RTimothyEdwards/caravel_openframe_project/docs/caravel_openframe.png

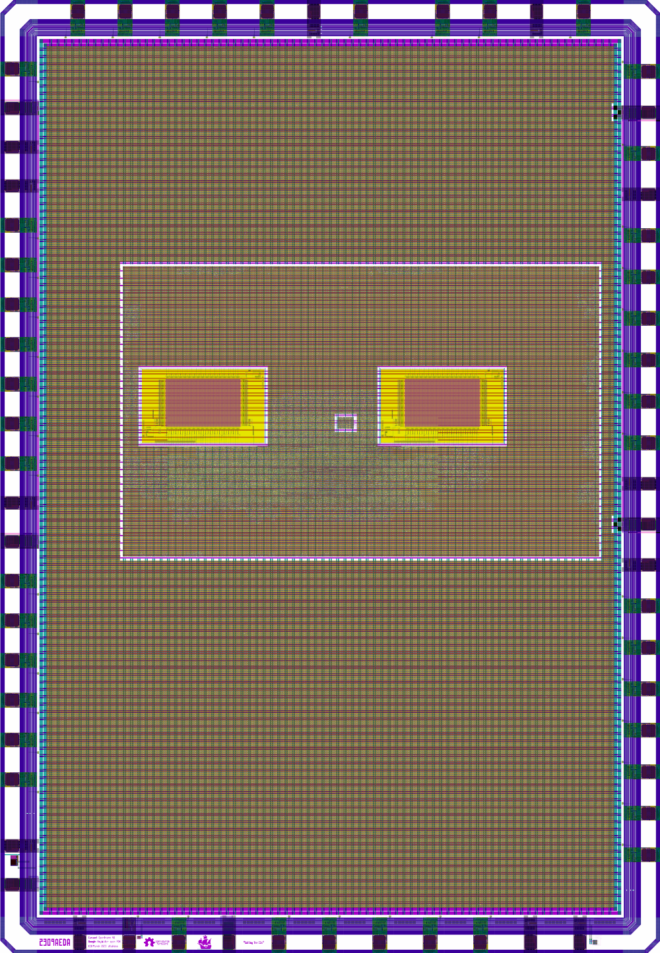
docs/caravel_openframe.png
