RTimothyEdwards/caravel_openframe_project/(threads)

Thread 1 (2023-05-14):

Select out of bounds on signal `gpio_dat_o[*]`

kareefardi, 2023-05-14:
In the following section, in `picorv32.v`:
```
	for (i = 0; i < 32; i = i + 1) begin
	    assign gpio_all_dat_o[i] = |(gpio_dat_o[i][`OPENFRAME_IO_PADS-1:0]);
	end
```

``[`OPENFRAME_IO_PADS-1:0]`` is out of bound for the 32 bus `gpio_data_o[i]`. I believe the intention behind the for loop was to OR all i'th bit of each PADS gpio bus. The current for loop doesn't accomplish that.

RTimothyEdwards, 2023-05-15:
@kareefardi :  iverilog seemed to be okay with it but I can't get the synthesis tools to understand it.  The intent seems perfectly clear but apparently somehow is not valid verilog (except to iverilog).  Do you know a way to restate it properly?

RTimothyEdwards, 2023-05-15:
@kareefardi :  Note that very little of this project has actually been tested through verilog testbenches.  There's only one testbench, but it tests the GPIO vector setting, so it actually validates iverilog's understanding of the "for" loop above, and iverilog handles it correctly.

RTimothyEdwards, 2023-05-15:
@kareefardi :  There is a `caravel_openframe_wrapper.def` file in `caravel_openframe_project/openlane/openframe_project_wrapper/fixed_dont_change/` which ultimately should reside in the `caravel` repository.  It is incomplete;  I copied it from the original user project wrapper and modified it for the correct openframe pins.  However, there are tracks and sites defined in it that correspond to the original user project wrapper and are limited to the smaller area that it has compared to the openframe area.  However, when I ran openlane, it appeared to honor the DIEAREA and used the entire area for placement.  I assume that Openlane/OpenROAD can rewrite a corrected DEF at some point in the flow?

So far, my attempt to run this through Openlane (and ignoring the for() loop error just to see if I could get through the entire flow) gets through placement, at which point it fails to complete placement and I'm not sure how to proceed from there.   Looking at the placement result, it looked fine, and the macros were placed correctly, but the number of logic gates looked way too low (and the sparse placement doesn't sync with the failure to complete placement).

Please bear in mind that the current state of this project is where I was just trying to get it to complete synthesis, place, and route.  I have made no attempt to verify anything or apply timing constraints, other than copying some files from the caravel management SoC that undoubtedly need editing.

kareefardi, 2023-05-16:
`gpio_dat_o` is a 44 x 32 array of arrays. The loop is attempting to access the i'th 32 bit bus while selecting a range of size 44. This results in the yosys warning of out of bounds.

RTimothyEdwards, 2023-05-24:
@kareefardi :  If you can suggest what the double loop would look like to concatenate the bits of an array instead of using the "|" operator which yosys will not apply to an array, then please post the solution here.

M0stafaRady, 2023-05-29:
I can see the same warning in VCS.

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

RTimothyEdwards, 2023-05-29:
Yes, it needs to be rewritten, if someone can suggest a valid way to rewrite it without running the "|" operator on the array.

M0stafaRady, 2023-05-30:
Can you review the suggestion at https://github.com/RTimothyEdwards/caravel_openframe_project/pull/5 ?

Closed 2023-06-01.

Thread 6 (2023-05-31):

How to chain the 2 timers?

M0stafaRady, 2023-05-31:
I tried to add test for chaining the 2 timers but I can't figure out the right configuration for the registers.

M0stafaRady, 2023-06-01:
The high counter start decrement when the low counter reached 0. but the high low counter didn't rollover it stays at 0.
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

here is the sequence I used
```
    // chain
    timer1_chain(1);
    timer0_chain(1);
    // count down
    timer1_upcount(0);
    timer0_upcount(0);
    // one shot
    timer1_oneshot(1);
    timer0_oneshot(1);
    // enable
    timer1_enable(1);
    timer0_enable(1);
    // setting data
    timer1_data(0x1);
    timer0_data(0xF);
```

Closed 2023-06-01.

Thread 7 (2023-06-01):

changing spi master mode gives wrong value

M0stafaRady, 2023-06-01:
When changing the spi master mode from 0 to 1 the written data at sdo is faster 1 cycle the the sck.
Here is a waveform of writing 0x1 when mode is 1(reading at negative edge )
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
This is read as 0x3

The waveform when writing 0x1 when mode is 0 (reading at posedge)
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

RTimothyEdwards, 2023-06-01:
I'm not sure what I'm looking at in the above graphs. . . SCK and SDO both from the SPI master?  In principle, it looks right;  the SDO is aligned with the rising edge of the clock in one mode and the falling edge of the clock in the other mode.  But do you have an SPI slave in the testbench that can also be put in mode 0 or mode 1?  The modes of master and slave have to match, or else yes, there will definitely be race conditions and misinterpretation of data.

M0stafaRady, 2023-06-02:
yes, sck and sdo are from the SPI master.
yes the slave works with different modes.

The mode that align with rising edge is functionally right only the last pose edge reads 1 at this example. However the mode that aligns with negative edge reads 1 at edges number 6 and 7 (counting from 0)
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

Here are some other trials sending byte in this mode to provide more details about the shift between clock driving and data sending.

try sending 0x00 but it sends 0x1
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

try sending 0x7F but it sends 0xFF
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

try sending 0x02 but it sends 0x05
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

try sending 0x03 but it sends 0x07
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

Thread 8 (2023-06-04):

Hold violation on path with start point `gpio_in[38]` (clock)

kareefardi, 2023-06-04:
```
Startpoint: gpio_in[38] (clock source 'clk')
Endpoint: _32086_ (rising edge-triggered flip-flop clocked by clk)
Path Group: clk
Path Type: min
Corner: Typical

Fanout     Cap    Slew   Delay    Time   Description
-----------------------------------------------------------------------------
                          0.00    0.00   clock clk (rise edge)
                          0.00    0.00   clock source latency
                  1.00    0.00    0.00 ^ gpio_in[38] (in)
     1    0.14                           gpio_in[38] (net)
                  1.11    0.05    0.05 ^ clkbuf_0_gpio_in[38]/A (sky130_fd_sc_hd__clkbuf_16)
                  0.13    0.35    0.40 ^ clkbuf_0_gpio_in[38]/X (sky130_fd_sc_hd__clkbuf_16)
     4    0.10                           clknet_0_gpio_in[38] (net)
                  0.13    0.01    0.41 ^ clkbuf_1_0__f_gpio_in[38]/A (sky130_fd_sc_hd__clkbuf_16)
                  0.16    0.23    0.64 ^ clkbuf_1_0__f_gpio_in[38]/X (sky130_fd_sc_hd__clkbuf_16)
     4    0.15                           clknet_1_0__leaf_gpio_in[38] (net)
                  0.16    0.01    0.65 ^ _26519_/B2 (sky130_fd_sc_hd__a22o_2)
                  0.03    0.14    0.79 ^ _26519_/X (sky130_fd_sc_hd__a22o_2)
     1    0.00                           _02974_ (net)
                  0.03    0.00    0.79 ^ _32086_/D (sky130_fd_sc_hd__dfxtp_1)
                                  0.79   data arrival time

                          0.00    0.00   clock clk (rise edge)
                          0.00    0.00   clock source latency
                  1.19    0.00    0.00 ^ gpio_in[38] (in)
     1    0.14                           gpio_in[38] (net)
                  1.30    0.06    0.06 ^ clkbuf_0_gpio_in[38]/A (sky130_fd_sc_hd__clkbuf_16)
                  0.14    0.41    0.47 ^ clkbuf_0_gpio_in[38]/X (sky130_fd_sc_hd__clkbuf_16)
     4    0.10                           clknet_0_gpio_in[38] (net)
                  0.14    0.01    0.48 ^ clkbuf_1_0__f_gpio_in[38]/A (sky130_fd_sc_hd__clkbuf_16)
                  0.16    0.25    0.73 ^ clkbuf_1_0__f_gpio_in[38]/X (sky130_fd_sc_hd__clkbuf_16)
     4    0.15                           clknet_1_0__leaf_gpio_in[38] (net)
                  0.18    0.04    0.77 ^ _15485_/A0 (sky130_fd_sc_hd__mux2_1)
                  0.05    0.17    0.94 ^ _15485_/X (sky130_fd_sc_hd__mux2_1)
     1    0.00                           _05023_ (net)
                  0.05    0.00    0.94 ^ _15486_/B (sky130_fd_sc_hd__and2b_2)
                  0.36    0.39    1.32 ^ _15486_/X (sky130_fd_sc_hd__and2b_2)
     2    0.07                           _05024_ (net)
                  0.36    0.02    1.34 ^ clkbuf_0__05024_/A (sky130_fd_sc_hd__clkbuf_16)
                  0.10    0.27    1.61 ^ clkbuf_0__05024_/X (sky130_fd_sc_hd__clkbuf_16)
     4    0.07                           clknet_0__05024_ (net)
                  0.10    0.01    1.62 ^ clkbuf_1_0__f__05024_/A (sky130_fd_sc_hd__clkbuf_16)
                  0.19    0.26    1.88 ^ clkbuf_1_0__f__05024_/X (sky130_fd_sc_hd__clkbuf_16)
    18    0.18                           clknet_1_0__leaf__05024_ (net)
                  0.19    0.01    1.89 ^ _15487_/B1 (sky130_fd_sc_hd__a21oi_2)
                  0.30    0.30    2.19 v _15487_/Y (sky130_fd_sc_hd__a21oi_2)
     2    0.14                           _00144_ (net)
                  0.30    0.02    2.21 v clkbuf_0__00144_/A (sky130_fd_sc_hd__clkbuf_16)
                  0.09    0.33    2.54 v clkbuf_0__00144_/X (sky130_fd_sc_hd__clkbuf_16)
     4    0.11                           clknet_0__00144_ (net)
                  0.09    0.00    2.54 v clkbuf_1_0_0__00144_/A (sky130_fd_sc_hd__clkbuf_8)
                  0.11    0.23    2.77 v clkbuf_1_0_0__00144_/X (sky130_fd_sc_hd__clkbuf_8)
     4    0.10                           clknet_1_0_0__00144_ (net)
                  0.11    0.00    2.78 v clkbuf_2_0_0__00144_/A (sky130_fd_sc_hd__clkbuf_8)
                  0.14    0.25    3.03 v clkbuf_2_0_0__00144_/X (sky130_fd_sc_hd__clkbuf_8)
     4    0.13                           clknet_2_0_0__00144_ (net)
                  0.16    0.04    3.07 v clkbuf_3_0_0__00144_/A (sky130_fd_sc_hd__clkbuf_8)
                  0.11    0.26    3.33 v clkbuf_3_0_0__00144_/X (sky130_fd_sc_hd__clkbuf_8)
     8    0.09                           clknet_3_0_0__00144_ (net)
                  0.11    0.01    3.34 v clkbuf_5_0_0__00144_/A (sky130_fd_sc_hd__clkbuf_8)
                  0.05    0.20    3.53 v clkbuf_5_0_0__00144_/X (sky130_fd_sc_hd__clkbuf_8)
     4    0.03                           clknet_5_0_0__00144_ (net)
                  0.05    0.00    3.54 v clkbuf_6_0__f__00144_/A (sky130_fd_sc_hd__clkbuf_16)
                  0.12    0.24    3.78 v clkbuf_6_0__f__00144_/X (sky130_fd_sc_hd__clkbuf_16)
    26    0.18                           clknet_6_0__leaf__00144_ (net)
                  0.12    0.01    3.78 v clkbuf_leaf_795__00144_/A (sky130_fd_sc_hd__clkbuf_16)
                  0.05    0.20    3.99 v clkbuf_leaf_795__00144_/X (sky130_fd_sc_hd__clkbuf_16)
     6    0.04                           clknet_leaf_795__00144_ (net)
                  0.05    0.00    3.99 v _1636_1645/A (sky130_fd_sc_hd__inv_2)
                  0.02    0.04    4.03 ^ _1636_1645/Y (sky130_fd_sc_hd__inv_2)
     1    0.00                           net5674 (net)
                  0.02    0.00    4.03 ^ _32086_/CLK (sky130_fd_sc_hd__dfxtp_1)
                          0.10    4.13   clock uncertainty
                          0.00    4.13   clock reconvergence pessimism
                         -0.03    4.10   library hold time
                                  4.10   data required time
-----------------------------------------------------------------------------
                                  4.10   data required time
                                 -0.79   data arrival time
-----------------------------------------------------------------------------
                                 -3.30   slack (VIOLATED)
```
The reason for opening this issue is that the start point and the clock triggering this path have the same source `gpio_in[38]` (`clk`) which is a bit odd.

M0stafaRady, 2023-06-04:
I guess the reason for this hold violation is that the gpio_all_dat_o[15] reads the input to the pads and in the case of gpio[38] the input is the clock.

I think remove dependency over `pad_gpio_in ` in gpio_all_dat_o would fix this. by removing it from the `iomem_rdata  `[register ](https://github.com/RTimothyEdwards/caravel_openframe_project/blob/main/verilog/rtl/gpio_wb.v#LL199C1-L200C1 )

We can also skip gpio[38] in the for loops by this we would lose reading any data from gpio[38].

RTimothyEdwards, 2023-06-04:
What used to be the clock on caravel is now a GPIO (in openframe) that is configured for input to use with the clock (for the project).  This situation should be exactly the same as for any existing user project in caravel that uses a GPIO input as a clock.  Please consult with Marwan as to how users are currently being advised on how to set up timing constraints for a clock input that is being passed to a user project from a GPIO on caravel.

shalan, 2023-06-05:
@RTimothyEdwards

We are hardening an example here. Apparently, there are different mode of operations and this requires cases analysis that cannot be done without a clear requirements document for the example.

Moreover, we need a detailed specs (a block diagram is nice to have) for the clocking module with detailed explanation of possible clocking options and exceptions in order to create correct implementation constraints.

Till we have such information, we cannot proceed.

RTimothyEdwards, 2023-06-05:
@shalan :  It's the same clocking structure that is used on caravel.  The only difference is that the clock pin is named `gpio[38]` instead of `clock`, since the pin is general-purpose as far as the openframe wrapper is concerned, but is used as a clock input by the project.  I had started a timing constraints file for the project, but I wasn't sure how to specify the clock in all places to make sure that openlane understands that pin `gpio[38]` is the input clock.

Thread 10 (2023-06-05):

Wrong dimensions for `gpio_analog_pol[33]` in template def

kareefardi, 2023-06-05:
`gpio_analog_pol[33]` is a met3 pin with width < met3 min width.

RTimothyEdwards, 2023-06-05:
The pin used to be attached to metal2 and so it is the width of metal2, but the underlying metal3 layer is sufficiently wide.  It looks like I should have run extraction before generating the DEF so that it would pick up the rest of the net;  by not doing so, it output only the pin label and area.

RTimothyEdwards, 2023-06-05:
But more to the point, all the other pins that had been on metal2 were resized to the full width of metal3, except `gpio_analog_pol[33]` was missed, which is a mistake.

RTimothyEdwards, 2023-06-07:
@kareefardi :  Should be fixed now.

Closed 2023-08-25.

Thread 16 (2023-08-17):

master spi interrupt behaviour

M0stafaRady, 2023-08-17:
The current interrupt in the spi master is triggered once the interrupt is enabled. Since the [condition](https://github.com/RTimothyEdwards/caravel_openframe_project/blob/e1d34518685f063b4ad780fe72eb6daa24768c79/verilog/rtl/simple_spi_master.v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) dependent on the done signal and the done signal is asserted most of the time.

If the correct behaviour is to send interrupt after each byte write, I suggest we might add the following:

```
reg done_delayed;

always @(posedge clk)
   done_delayed <= done;

assign  irq_out = irqena & done & ~done_delayed;
```

M0stafaRady, 2023-08-28:
fixed by merging https://github.com/RTimothyEdwards/caravel_openframe_project/pull/18

Closed 2023-08-28.

Thread 21 (2023-09-18):

Needs multiple power supply connections

RTimothyEdwards, 2023-09-18:
The example needs to demonstrate how to connect multiple supply domains together to boost the current capacity of the supply feeding the user wrapper circuit and to minimize I-R drop across the user wrapper circuit.  This example project should connect together the `vccd`, `vccd1`, and `vccd2` domains into a single power supply.

Thread 22 (2023-09-18):

Need reset synchronization

RTimothyEdwards, 2023-09-18:
The openframe project fails one testbench where the CPU fails to start up after bringing the chip out of SPI reset.  Both the RESETB pin and the SPI reset need to be synchronized to the core clock.

Since the housekeeping SPI resets only on the POR signal, then there is no problem simply synchronizing the core reset to the core clock.  The implementation should allow the reset to be set at any time, but the reset should only be released in synchronization with the clock (on the falling edge, to give a clock half-cycle time between reset release and the next clock positive edge).

The implementation should be:  `all_resetb = (RESETB pin & SPI resetb) ;  core_resetb = (all_resetb & all_resetb_sync)` where `all_resetb_sync` is `all_resetb` passed through two flops clocked by the inverse of the core clock, and reset to zero on `porb`.

RTimothyEdwards, 2023-09-18:
Actually the reset _is_ synchronized (in the `clock_routing.v` file).  It just incorrectly uses the clock positive edge instead of the clock negative edge (`clock_routing.v` line 128).
