RTimothyEdwards/caravel_openframe_project/(commit log)

2023-04-29 Added initial files (some still need substantial editing) for the openlane build of the example project.
    [macro.cfg, pin_order.cfg]
2023-05-09 This commit is mostly corrections to the verilog code for problems found during experimental synthesis and P&R.
    [macro.cfg]
2023-05-24 Corrected two connections to gpio_vector_in which were incorrectly specified (and connecting in the wrong direction). This fixes issue #2 posted by Mostafa Rady.
    [picosoc.v]
2023-05-28 Fix syntax error in RTL moving default parameters to the top of the module intercon_wb
    [intercon_wb.v]
2023-05-29 Added uart test that test tx and rx and chaning the clk div
2023-05-30 RTL: fix wrong combing of gpio configuration read data
    [picosoc.v]
2023-05-31 Adding timer tests
2023-06-04 Add tests for housekeeping registers access using spi
2023-06-05 Changed the reset signal to picosoc from ~resetb to ~core_rstn so that (1) it is a synchronized reset, and (2) it picks up the external reset from housekeeping.
    [picosoc.v]
2023-06-07 Updated the project wrapper DEF file to correspond to the latest fixes made to the wrapper in caravel (currently under a branch, to be merged to main).
2023-08-20 fix RTL bugs before GL
    [counter_timer_high.v, counter_timer_low.v, picosoc.v, simple_spi_master.v]
2023-08-21 Update README.rst with description of spi modes
2023-08-27 revert changes to the timer reset_value setter
    [counter_timer_high.v, counter_timer_low.v]
2023-08-28 Fixed two syntax errors per PR #20 from Mostafa Rady (except that the pull request contains too many other changes, so I'm just doing this one by hand).
    [counter_timer_high.v, counter_timer_low.v]
2023-08-28 Added corrections to verilog source and configurations for the openlane macro hardening and top level synthesis. Removed old files that corresponded to the caravan design and not to the openframe des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
    [macro.cfg, pin_order.cfg]
2023-09-15 Added a large amount of information to the README file, especially about design considerations for openframe designs, and details about how the example was architected. Made a few additions and corre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
    [picosoc.v]
2023-09-22 Regenerated the DEF file for the openframe_project_wrapper cell after fixing an issue that cropped up in magic where obstruction layers intended to be used as blockages in DEF were not output in the 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
2023-09-27 Copied the project wrapper layout DEF file from the caravel project, where it was updated today with a number of fixes, most of them minor (slight shifts in pin position to keep them all on a 10nm gr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
2023-10-02 Another update to the openframe project wrapper DEF file to add some power pads that were missing (see corresponding update to the efabless/caravel repository).
